Hasboyyy/ESP32-Based-APRS-Weather-Station/Hardware/BH1750.jpg

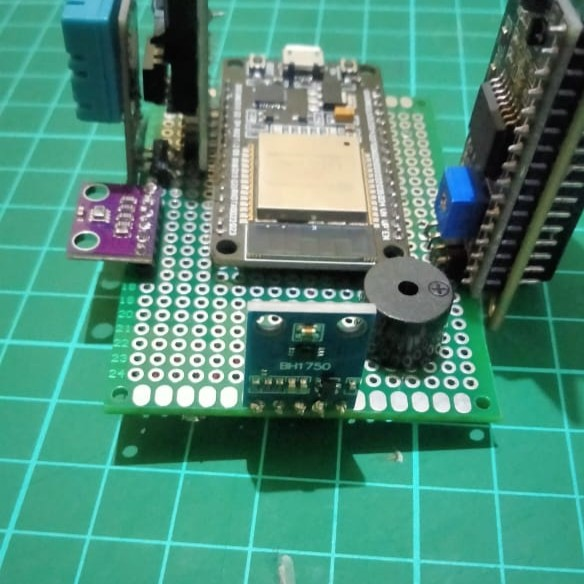
Hardware/BH1750.jpg
