Hasboyyy/ESP32-Based-APRS-Weather-Station/Hardware/DHTBMP.jpg

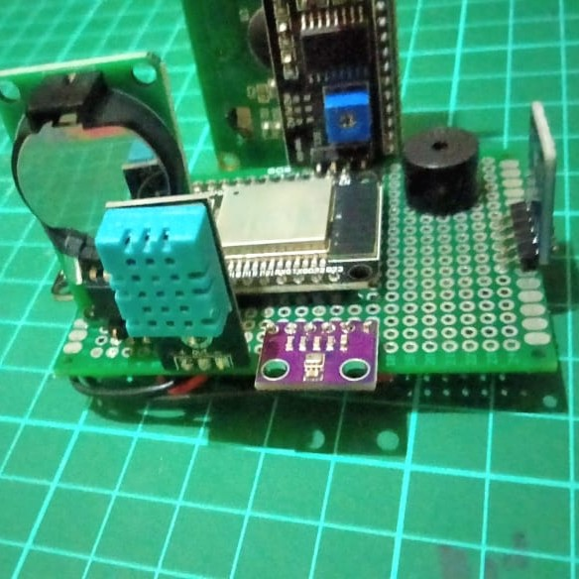
Hardware/DHTBMP.jpg
