Hasboyyy/ESP32-Based-APRS-Weather-Station/Hardware/Interface 1.jpg

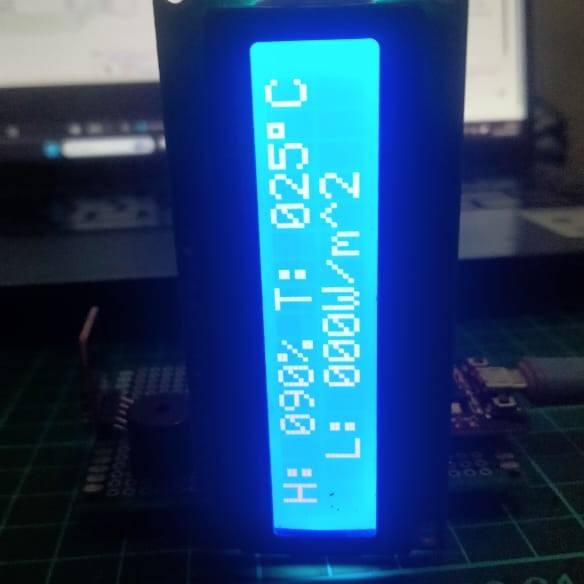
Hardware/Interface 1.jpg
