Hasboyyy/ESP32-Based-APRS-Weather-Station/Hardware/Interface 2.jpg

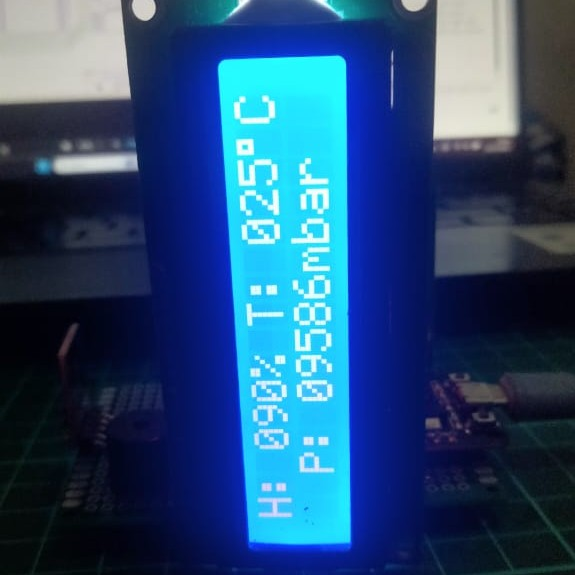
Hardware/Interface 2.jpg
