Hasboyyy/ESP32-Based-APRS-Weather-Station/Hardware/MQTT and APRS.png

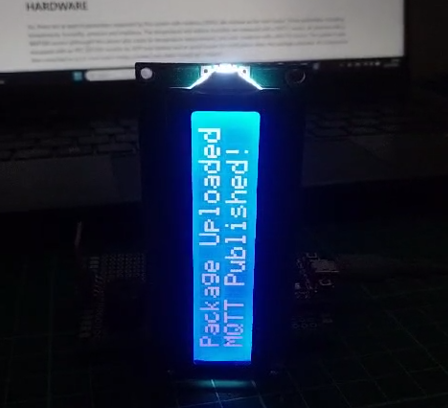
Hardware/MQTT and APRS.png
