Hasboyyy/ESP32-Based-APRS-Weather-Station/(commit log)

2025-01-23 Create schematic
2025-01-23 Update and rename configuration.h to configuration.h
    [configuration.h]
